aleitner/pc98-floppy-station/app/static/fonts/README.txt

DotGothic16 (Fontworks) and VT323 (Peter Hull), both under the SIL Open Font License 1.1:
https://openfontlicense.org/open-font-license-official-text/
Downloaded from Google Fonts in October 2026. Used by the Floppy Station window.
