aleitner/pc98-floppy-station/docs/img/2_portrait_rear.png

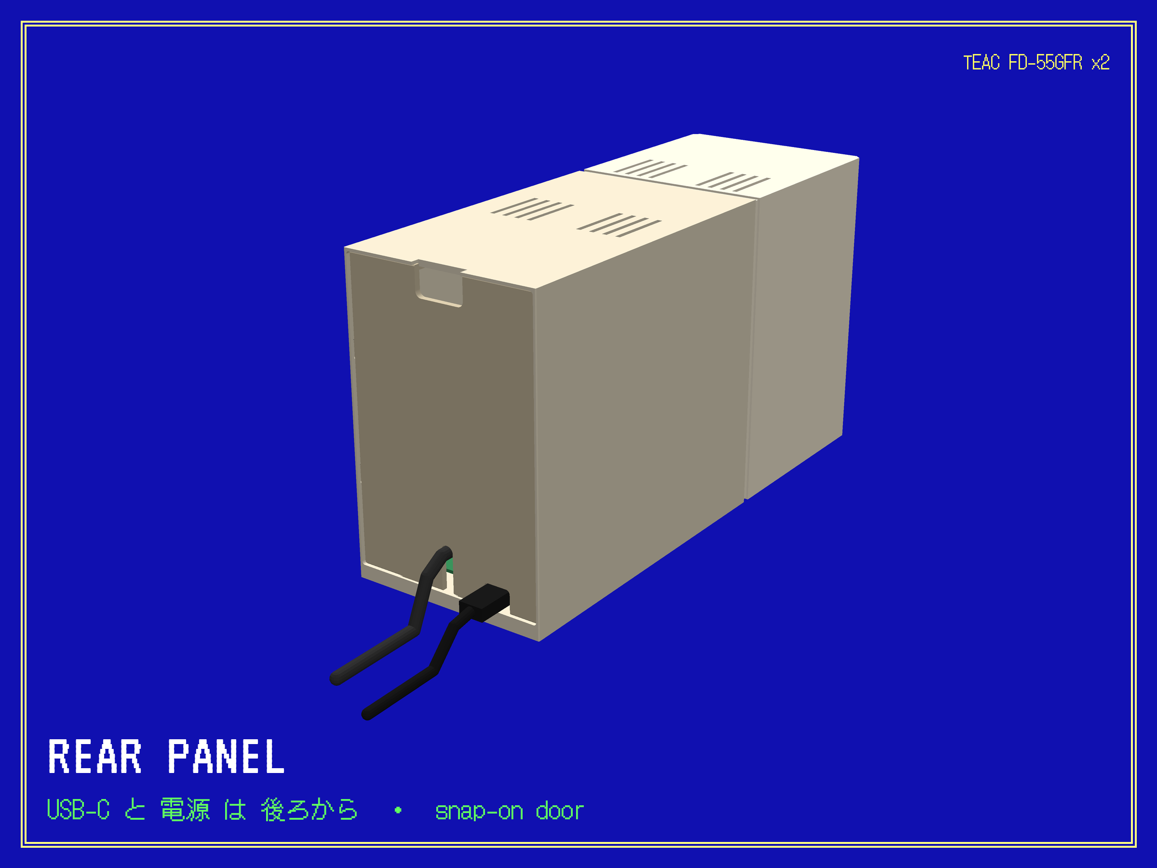
docs/img/2_portrait_rear.png
