aleitner/pc98-floppy-station/docs/img/3_portrait_exploded.png

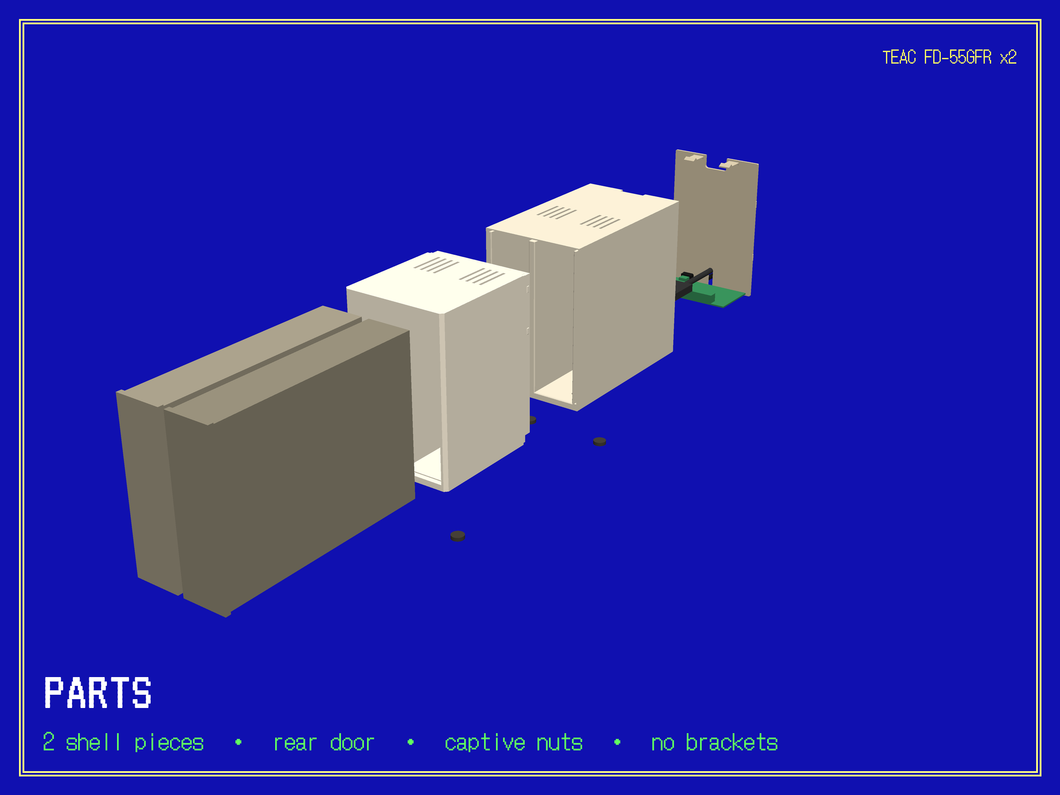
docs/img/3_portrait_exploded.png
