aleitner/pc98-floppy-station/docs/img/4_landscape_front.png

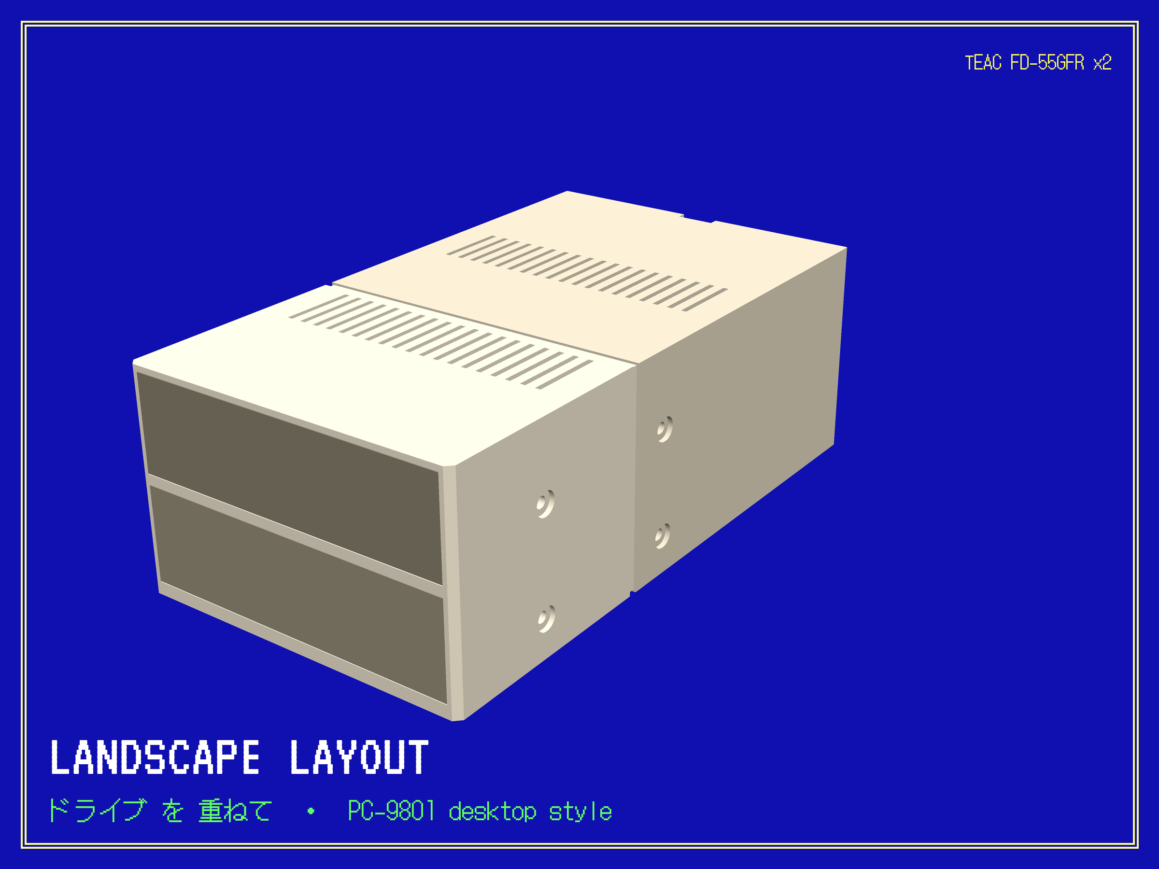
docs/img/4_landscape_front.png
