aleitner/pc98-floppy-station/docs/img/5_landscape_exploded.png

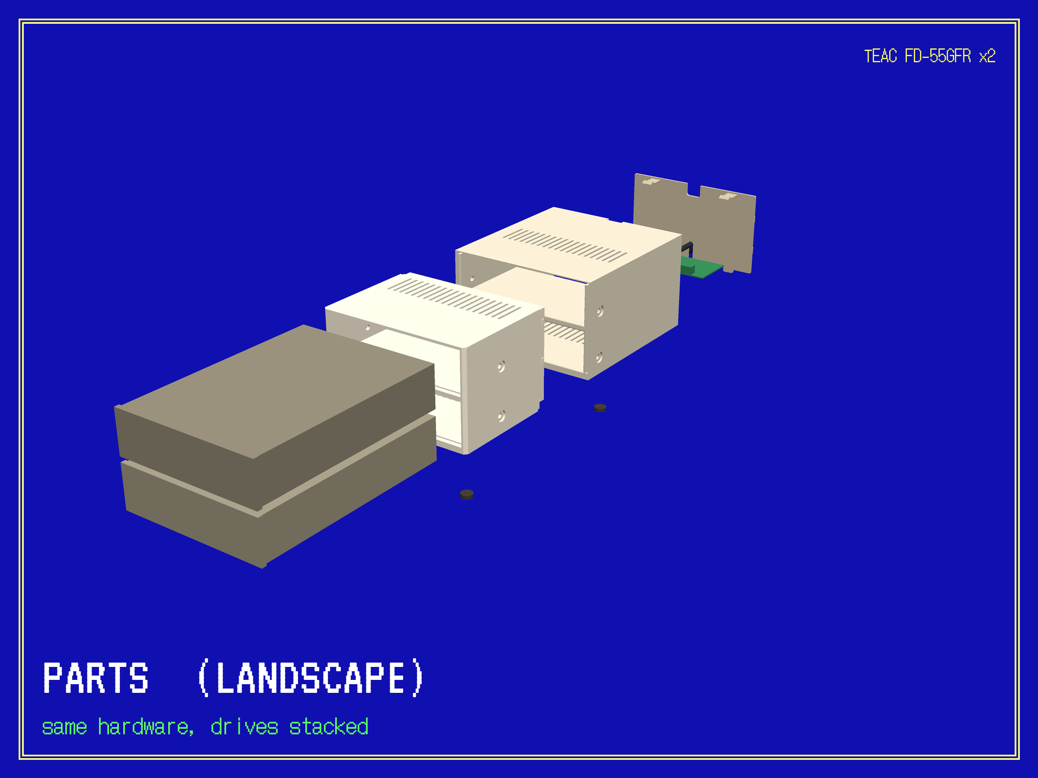
docs/img/5_landscape_exploded.png
