aleitner/pc98-floppy-station/print/A_PORTRAIT_drives_side_by_side/PC98_PORTRAIT_3_back_panel_v13.stl

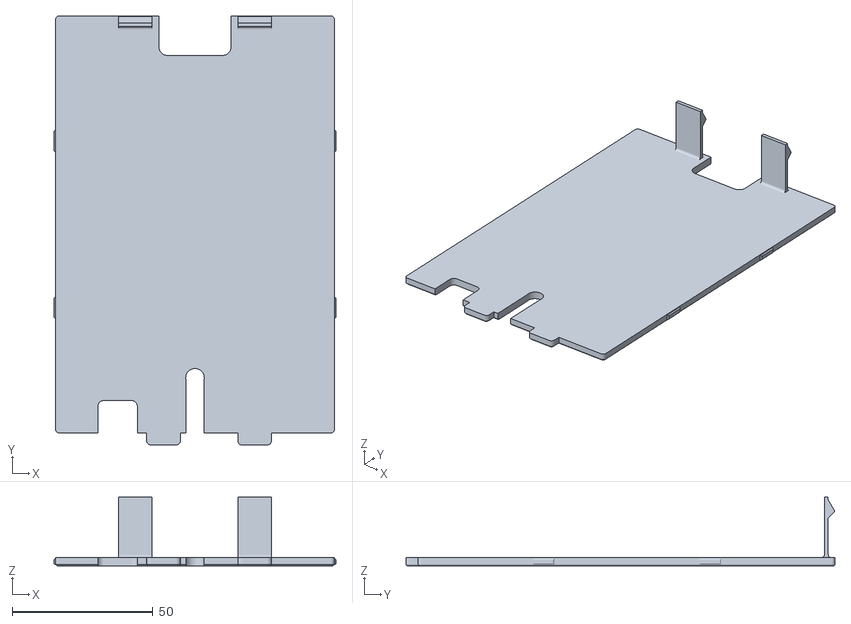
[picture p6: CAD file, 2026-10-31]
print/A_PORTRAIT_drives_side_by_side/PC98_PORTRAIT_3_back_panel_v13.stl
100.1 x 152.5 x 24.5
