aleitner/pc98-floppy-station/print/B_STACKED_drives_one_above_other/PC98_STACKED_3_back_panel_v13.stl

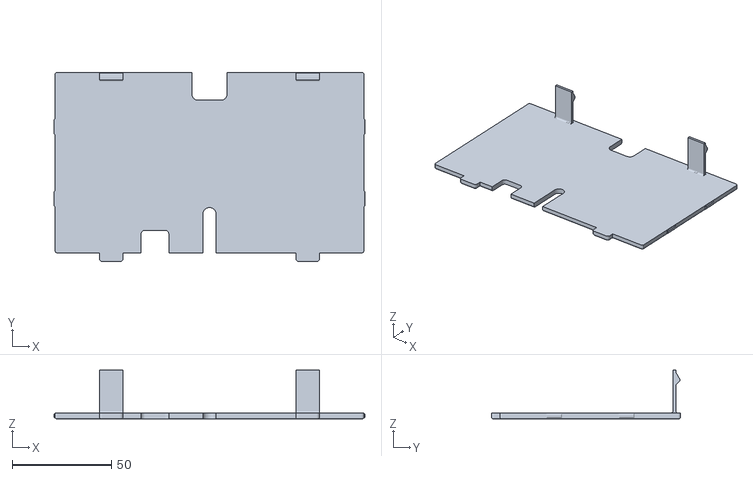
[picture p7: CAD file, 2026-10-31]
print/B_STACKED_drives_one_above_other/PC98_STACKED_3_back_panel_v13.stl
156.7 x 95.3 x 24.5
