aleitner/pc98-floppy-station/print/B_STACKED_drives_one_above_other/PC98_STACKED_2_shell_REAR_v13.stl

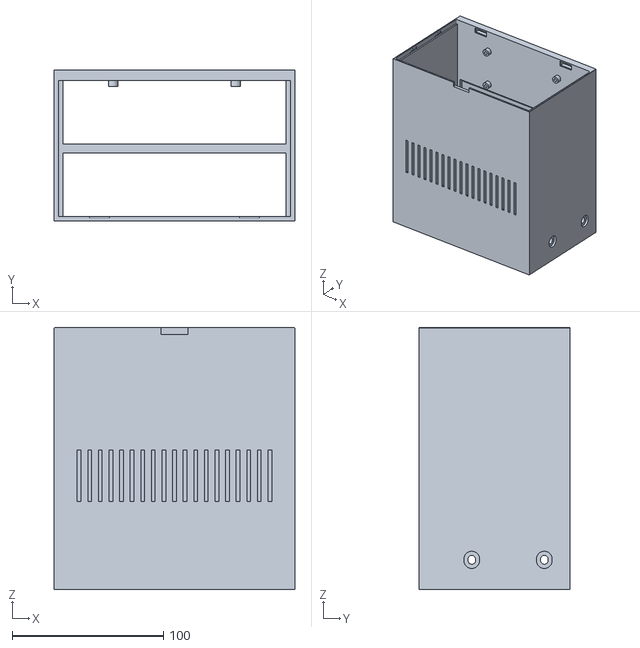
[picture p9: CAD file, 2026-10-31]
print/B_STACKED_drives_one_above_other/PC98_STACKED_2_shell_REAR_v13.stl
159.0 x 99.8 x 173.0
