aleitner/pc98-floppy-station/print/A_PORTRAIT_drives_side_by_side/PC98_PORTRAIT_0b_FIT_TEST_rear_ring_v13.stl

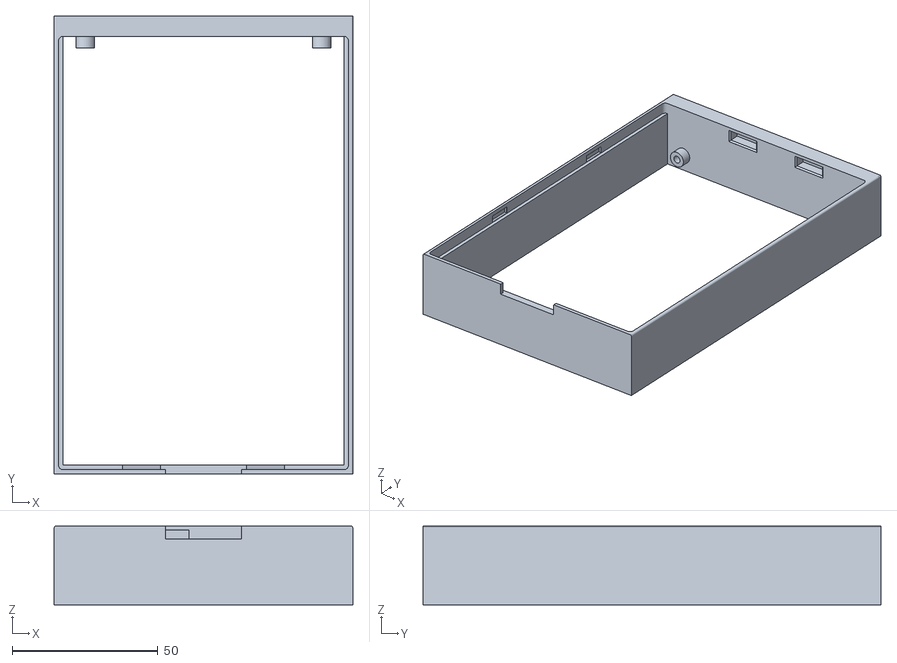
[picture p10: CAD file, 2026-10-31]
print/A_PORTRAIT_drives_side_by_side/PC98_PORTRAIT_0b_FIT_TEST_rear_ring_v13.stl
102.4 x 157.0 x 27.0
