aleitner/pc98-floppy-station/(list of files, cad)

Other CAD files:
print/A_PORTRAIT_drives_side_by_side/PC98_PORTRAIT_0a_FIT_TEST_front_ring_v13.stl
print/B_STACKED_drives_one_above_other/PC98_STACKED_0b_FIT_TEST_rear_ring_v13.stl
print/A_PORTRAIT_drives_side_by_side/PC98_PORTRAIT_2_shell_REAR_v13.stl
print/B_STACKED_drives_one_above_other/PC98_STACKED_1_shell_FRONT_v13.stl
