aleitner/pc98-floppy-station/(commit log)

2026-10-31 Enclosure model, print pack v13, parts list, bridge and site
    [PC98_PORTRAIT_0a_FIT_TEST_front_ring_v13.stl, PC98_PORTRAIT_0b_FIT_TEST_rear_ring_v13.stl, PC98_PORTRAIT_1_shell_FRONT_v13.stl, PC98_PORTRAIT_2_shell_REAR_v13.stl, PC98_PORTRAIT_3_back_panel_v13.stl, PC98_STACKED_0a_FIT_TEST_front_ring_v13.stl, PC98_STACKED_0b_FIT_TEST_rear_ring_v13.stl, PC98_STACKED_1_shell_FRONT_v13.stl]
2026-10-31 Open the window even when the disk driver is missing
2026-10-31 Write guard on track 0, disk-layer and window tests, safety notes
2026-10-31 Load into memory: a second way to play that needs no driver
2026-10-31 Correct the build steps and other documentation findings from the audit
    [pc98_disk_unit.scad]
2026-10-31 Second audit: canonical static path, cached board lookup, locks, page guards, documentation fixes
    [pc98_disk_unit.scad]
2026-10-31 Second audit: current Mac runners, Windows Documents lookup, UTF-8 child pipes, tray off its own thread
2026-10-31 One way to play: everything goes through the bridge
    The window no longer has a second code path for two images; an image stands in for a drive
    inside the bridge itself (--image), so the emulator always sees the same two files and the
    same save logic. Dropped with it: the program's own window engine and tray icon (a bare
    browser window or a tab is all that remains), the port file, the driver check as a separate
    process, and the prose parsing of the bridge's output, which now prints one line per drive
    that the window reads.
    Drive layer: the board is opened once and handed to both drives, image files take their
    protection from the file's own permissions, and the disk object is a plain read_at/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
2026-10-31 Say in plain words why the drives can't be reached
    A failed check of the drives showed the library's raw error, e.g. "(22, 'Invalid argument')".
    The window now translates it: not connected, in use by another program, no permission on the
    port, or didn't answer (unplug and plug in again); the full traceback goes to station.log.
    The board is also locked while a program holds it, so a second copy, or gw running at the
    same time, is refused instead of the two garbling each other's commands.
    The server's port can be set with PC98_STATION_PORT, which the test uses to run beside a
    real copy of the program.
2026-10-31 Packaged build couldn't open the drives on glibc 2.42+
    Every Start and Check in the packaged program ended in "(22, 'Invalid argument')" on the
    Steam Deck, while the same code from source worked. The Greaseweazle listens for two
    control baud rates (10000 and 9600); the released pyserial 3.5 passes the BOTHER marker to
    tcsetattr for the first, which a Python built against an older C library rejects on glibc
    2.42 or newer. pyserial's main branch sets a placeholder rate first and applies the real one
    through TCSETS2, so CI installs pyserial from that commit before the Greaseweazle package.
    The bridge now prints the plain-words reason too (the translation lives in bridge_paths, next
    to the othe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
2026-10-31 Drop the Copy buttons: the path is selectable text, and the emulator command fills paths in itself
2026-10-31 Cut the site and README down to five steps
    Print, buy parts, put together, get the bridge, run. The site's seven pages become a short
    welcome and those five steps; the README is the same list with links. What a builder doesn't
    need on the way is gone from both: how the bridge works, test status, running from source,
    the size table (still in the print README). The list of what protects a disk moves to
    app/BRIDGE.md, and the warning to clean the heads and back up originals stays on the Run page.
    This also drops two stale README claims: that two backups need no driver, and that saving and
    swaps were untested.
2026-10-31 Run on Windows: real-drive fixes, and the exe joins the release
    Tested on Windows 11 with two real drives: Xak II boots and plays, and
    disk swaps are seen. Saving to a real disk is still untested there.
    - Reset the board when opening it. It remembers head positions between
    programs, and a wrong memory put every track 4 cylinders off.
    - Read a disk's label once per disk. The window asked every second and
    an unreadable track isn't cached, so the drive retried without end.
    - Mount drive letters as a network volume on Windows. On a local volume
    something, probably the virus scanner, read the whole file on every
    open: a minute of stepping through the floppy, with the emulator stuck.
    - Ma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
2026-11-01 List everything playing needs, and what to do about each
    A box at the top of the window names what's missing, in order, with the next step: the
    Greaseweazle, the disk driver, RetroArch, the PC-98 core and the BIOS files, in the folder
    RetroArch's own settings give. Each line turns OK by itself once it's done, and the box goes
    away when nothing is missing. The driver no longer needs a restart, and plugging the board in
    checks the drives.
    The driver check now notices the library without its fusermount command. A firmware problem
    arrives as a message instead of the library ending the process, and a drive without power says
    so instead of showing no disk.
2026-11-01 Close the ways a write could reach the wrong disk
    Writes: a file opened before a swap can no longer write. A write that changes the disk's name
    in its boot sector is refused with everything after it, which stops a program writing back a
    whole image of another disk. A drive stays read-only until it has been seen empty once, proving
    it can report a swap, and a swap survives a check that fails after clearing the latch or a head
    re-seat that would have cleared it.
    Tracks: a write rebuilds a whole track, so a track with extra or duplicate sectors or
    deleted-data marks, as copy protection uses, is no longer writable, and backups count them. A
    track that failed to read can't be written until the d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
2026-11-02 Play from real drives without pauses, see every disk swap, and check the track under the head before every save
2026-11-05 Serve the drives as D88 so copy protection reaches the game, and back up each disk once as raw flux with a D88 beside it
    A plain sector image can't hold the extra sectors and read errors copy protection checks for,
    so Xak II's church stayed locked. The drives are now served as D88 files: a fixed slot per
    track, every sector with its ID and status, and a save is let through only where it changes a
    plain sector. A track whose own sectors partly fail to read is served as it reads; one whose
    sectors name another cylinder means the head is off, and the backup stops at once on it.
    Backups read every track once, three turns, past the format's last cylinder, and keep the flux
    (.scp) and a D88 made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
